Shpergl/Automotive/AC_controller/hw/Project Outputs for AC_controller/BOM/Bill of Materials.PDF

Component | list | | Bill of Materials for Project [AC_controller.PrjPcb] (No PCB Document Selected)
Source Data From: AC_controller.PrjPcb | | Contact: | | Generated by:
Project: AC_controller.PrjPcb | <Parameter ClientCompanyName not found>
Variant: | None | <Parameter ClientContactName not found> | FEDEVEL <Parameter ClientContactEmail not found>
Report Date: | 1/3/2025 | 2:23 PM | <Parameter ClientWebsite not found> | http://www.fedevel.com

### Print Date: 03-Jan-25 2:23:46 PM

# | #Column Name Error:' Category | Manufacturer 1 | Manufacturer Part Number 1 | Footprint | Description | Quantity | Supplier 1 | Supplier Part Number 1 | Supplier Order Qty 1 | Supplier Stock 1 | Supplier Unit Price 1 | Supplier Subtotal 1 | Supplier Currency 1

1 | | | | CAPAE430X550N | ELCO 20% | 3 | Farnell | 647-UWF1C100MCL1GB
2 | | | | CAPC2012X88N | X7R 10% 0805 | 8 | Farnell | 80-C0805C104K9R
3 | | | | CAPC2012X88N | | 4 | Farnell
4 | | Panasonic | EEE-FC1E101AP | CAPAE9983X102N | PANASONIC - EEEFC1E101AP - CAP, ALU | 2 | Farnell | 2254349 | | 500 | | | EUR
5 | | Murata | GRM21BR71C475KA73L | CAPC2012X140N | X7R 10% 0805 | 4 | Farnell | 1797015 | 12 | 0 | 0.45 | 5.44 | GBP
6 | | | | CN_10pin_MFGK-10 | Molex, Micro-Fit 3.0, 43045, 10 Way, 2 | 1 | kosmodrom.ua | 00-00041120
7 | | | | CN_20pin_MFGK-20 | Molex, Micro-Fit 3.0, 43045, 20 Way, 2 | 1 | kosmodrom.ua | 00-00041123
8 | | Vishay Lite-On | LTV-817S | IC_LiteOn_ LTV-817S | Transistor Output Optocouplers | 8 | Mouser | 859-LTV-817S | 24 | 14850 | 0.24 | 5.69 | USD
9 | | | | DO-214AC | Transient Voltage Suppressors | 2 | | SMAJ15A
10 | | | | MCH_BSC_SS_112L | Small relay 6 pins 12V, 2A | 5
11 | | | | | | 1
12 | | | | DO-214AC | M7 Diode, max 30A | 4
13 | | | | VSSOP-10 | Analog to Digital Converters - ADC 16B | 1
14 | | Raspberry Pi | SC0915 | MOD_Raspberry_Pi_Pico | Single Board Computers Raspberry Pi Pico | 1 | Mouser | 358-SC0915 | 3 | 8321 | 4.00 | 12.00 | USD
15 | | | | MOD_MCP2515 | CAN bus module | 1 | Arduino.ua
16 | | | | MOD_MP1584_3A | DC-DC converter 3A | 2 | Arduino.ua
17 | | Nexperia | BC847B215 | SOT23 | Bipolar Transistors - BJT NPN 45V 100mA | 5 | Mouser | 771-BC847B-T/R | 15 | 163004 | 0.07 | 0.99 | USD
18 | | | | TO-252 | 30V P-Channel MOSFET | 2
19 | | Nexperia | 2N7002BKW115 | SOT65P210X110-3N | NXP - 2N7002BKW - MOSFET, N CH, 60V, | 2 | Farnell | 1894713RL | | 16273 | | | EUR
20 | | | | RESC2012X60N | RESISTOR, 0805, 1K, 1%, SMD | 11 | Farnell | 9237496
21 | | | | RESC2012X60N | RESISTOR, 0805, 10K, 1%, SMD | 19 | Farnell
22 | | Yageo | RC0805FR-074K7L | RESC2012X60N | RESISTOR, 0805, 4K7, 1%, SMD | 1 | Farnell | 9237704 | | 650700 | | | EUR
23 | | | | RESC2012X60N | RESISTOR, 0805, 100K, 1%, SMD | 3 | Farnell
24 | | Vishay Dale | RCG08050000Z0EA | RESC2012X60N | Thick Film Resistors - SMD ZERO OHM | 2 | Mouser | 71-RCG08050000Z0EA | 6 | 14668 | 0.12 | 0.72 | USD
25 | | Yageo | RC0805FR-07100RL | RESC2012X60N | RESISTOR, 0805, 100R, 1%, SMD | 15 | Farnell | 9237364 | 45 | 997154 | 0.02 | 0.86 | EUR
| | | | | | 108 | | | 105 | 25.695
Approved | | | | Notes Price for 1pcs | | | | | | | | USD
3 pcs: | Total | USD

25.695

8.57
