Shpergl/Automotive/AC_fan/hw/AC_fan/Project Outputs for AC_fan/BOM/Bill of Materials-AC_fan.xlsx

Comment | Description | Designator | Footprint | LibRef | Quantity
CN_2pin_XT60PW-M | 30A, 2 pin | CN1, CN3 | CN_2pin_XT60-M | 02_10140 | 2
CN_1X2M |  | CN2 | CN_XH2.54-2P-MALE | 02_10135 | 1
DIO | Schottky Diodes & Rectifiers 3 Amp 30 Volt | D1 | DO-201AD-Horizontal | 03_00101 | 1
IC_LiteOn_LTV817 | Transistor Output Optocouplers Optocoupler Phototrans | D2 | IC_LiteOn_ LTV-817S | 07_00275 | 1
TRS_IRFP2907PbF | N-channel Power MOSFET Si 75V 209A 3-Pin(3+Tab) | Q1 | TO-247AC | 19_00049 | 1
RES | RESISTOR, 0805, 330R, 1%, SMD, RESISTOR, 0805, 10K, 1%, SMD | R2, R3, R4 | RESC2012X60N | 15_00323, 15_00341 | 3
