Shpergl/Automotive/AC_fan/hw/AC_fan/Project Outputs for AC_fan/ExportSTEP/AC_fan.step

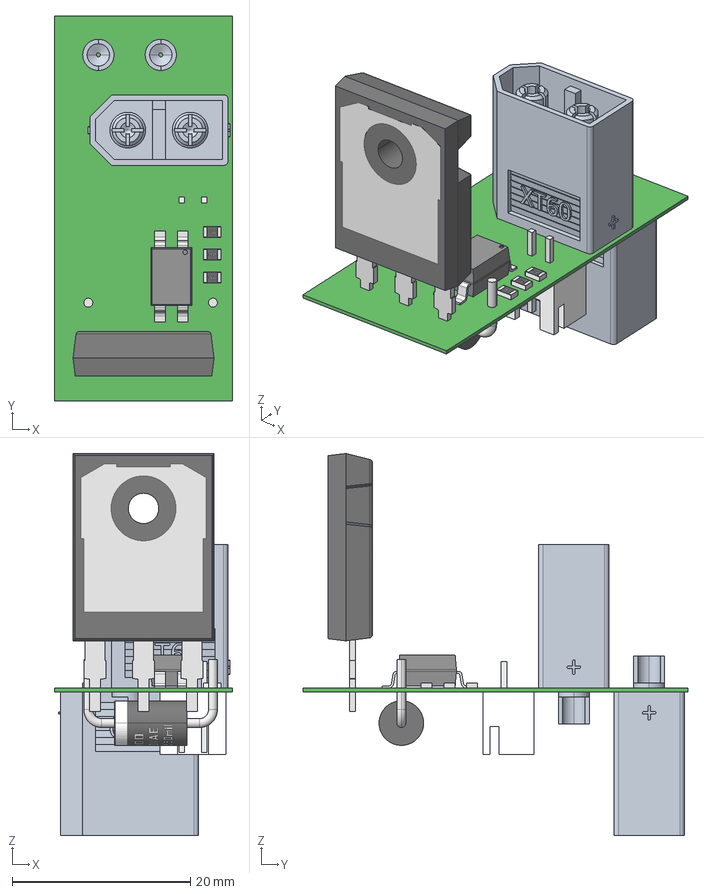
[picture p1: CAD file, 2025-03-06]
AC_fan/hw/AC_fan/Project Outputs for AC_fan/ExportSTEP/AC_fan.step
20.0 x 43.1 x 42.8 mm
TO-247AC_Normal_Size_rev1.1
XT60_Macho x 2
DO-201AE_Normal_550mil_rev1.0
RES_0805 x 3
SW3dPS-4-SMD
JST B2B-XH-A
