Shpergl/Automotive/(list of files, cad)

Other CAD files:
AC_fan/hw/AC_fan/Project Outputs for AC_fan/ExportSTEP/AC_fan_v_1_0.step
