Shpergl/Automotive/AC_controller/hw/Project Outputs for AC_controller/Schematic Print/Schematic Prints.PDF

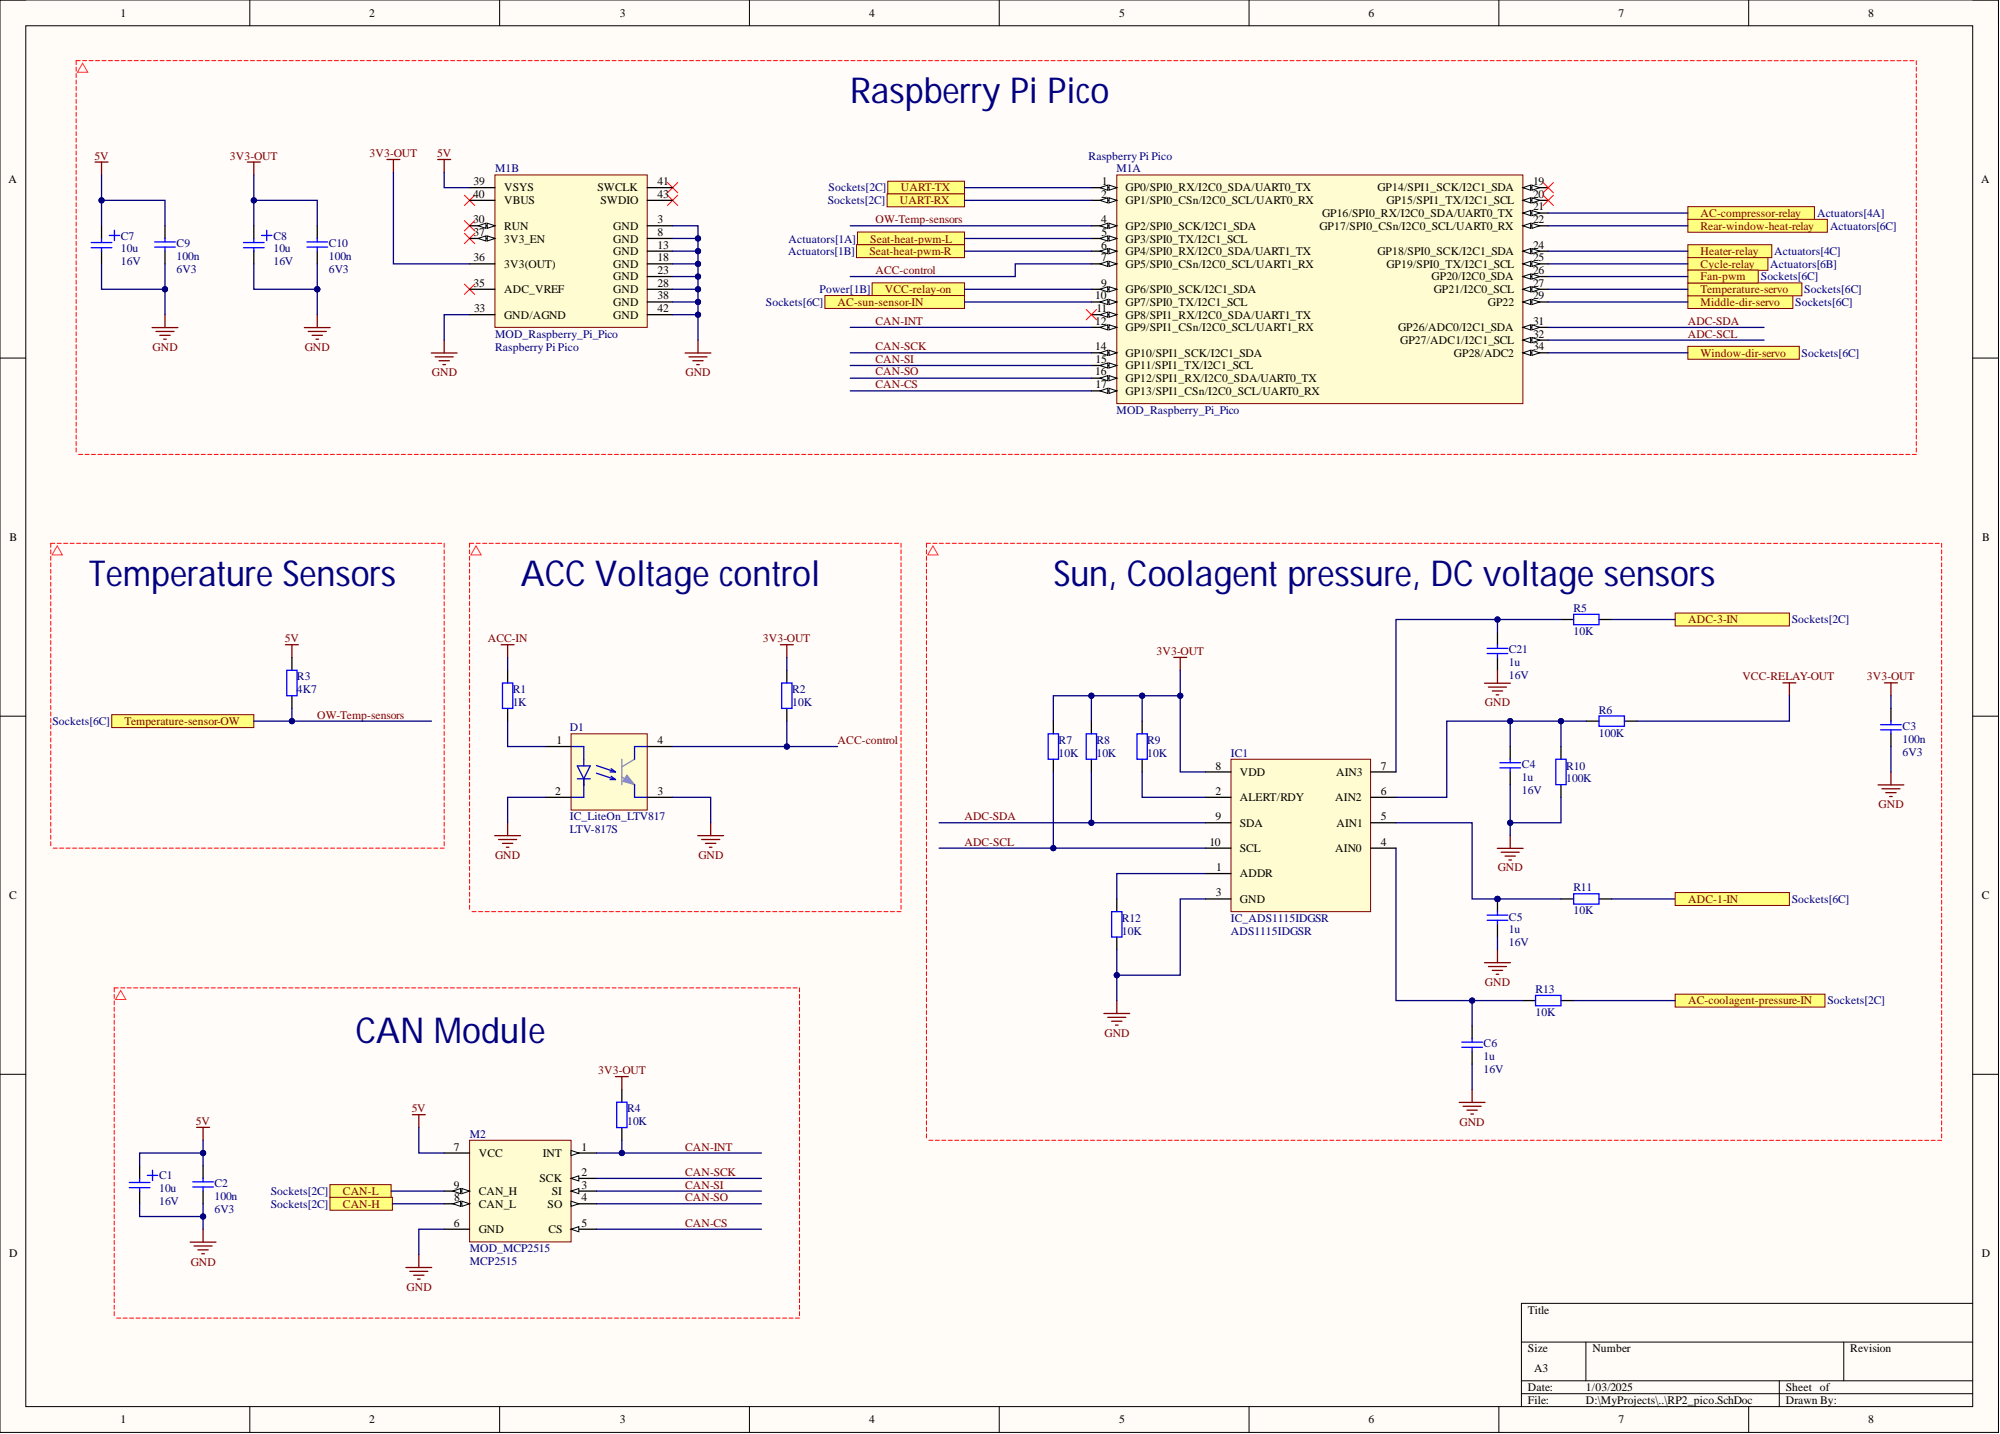
[picture p2: page 1]

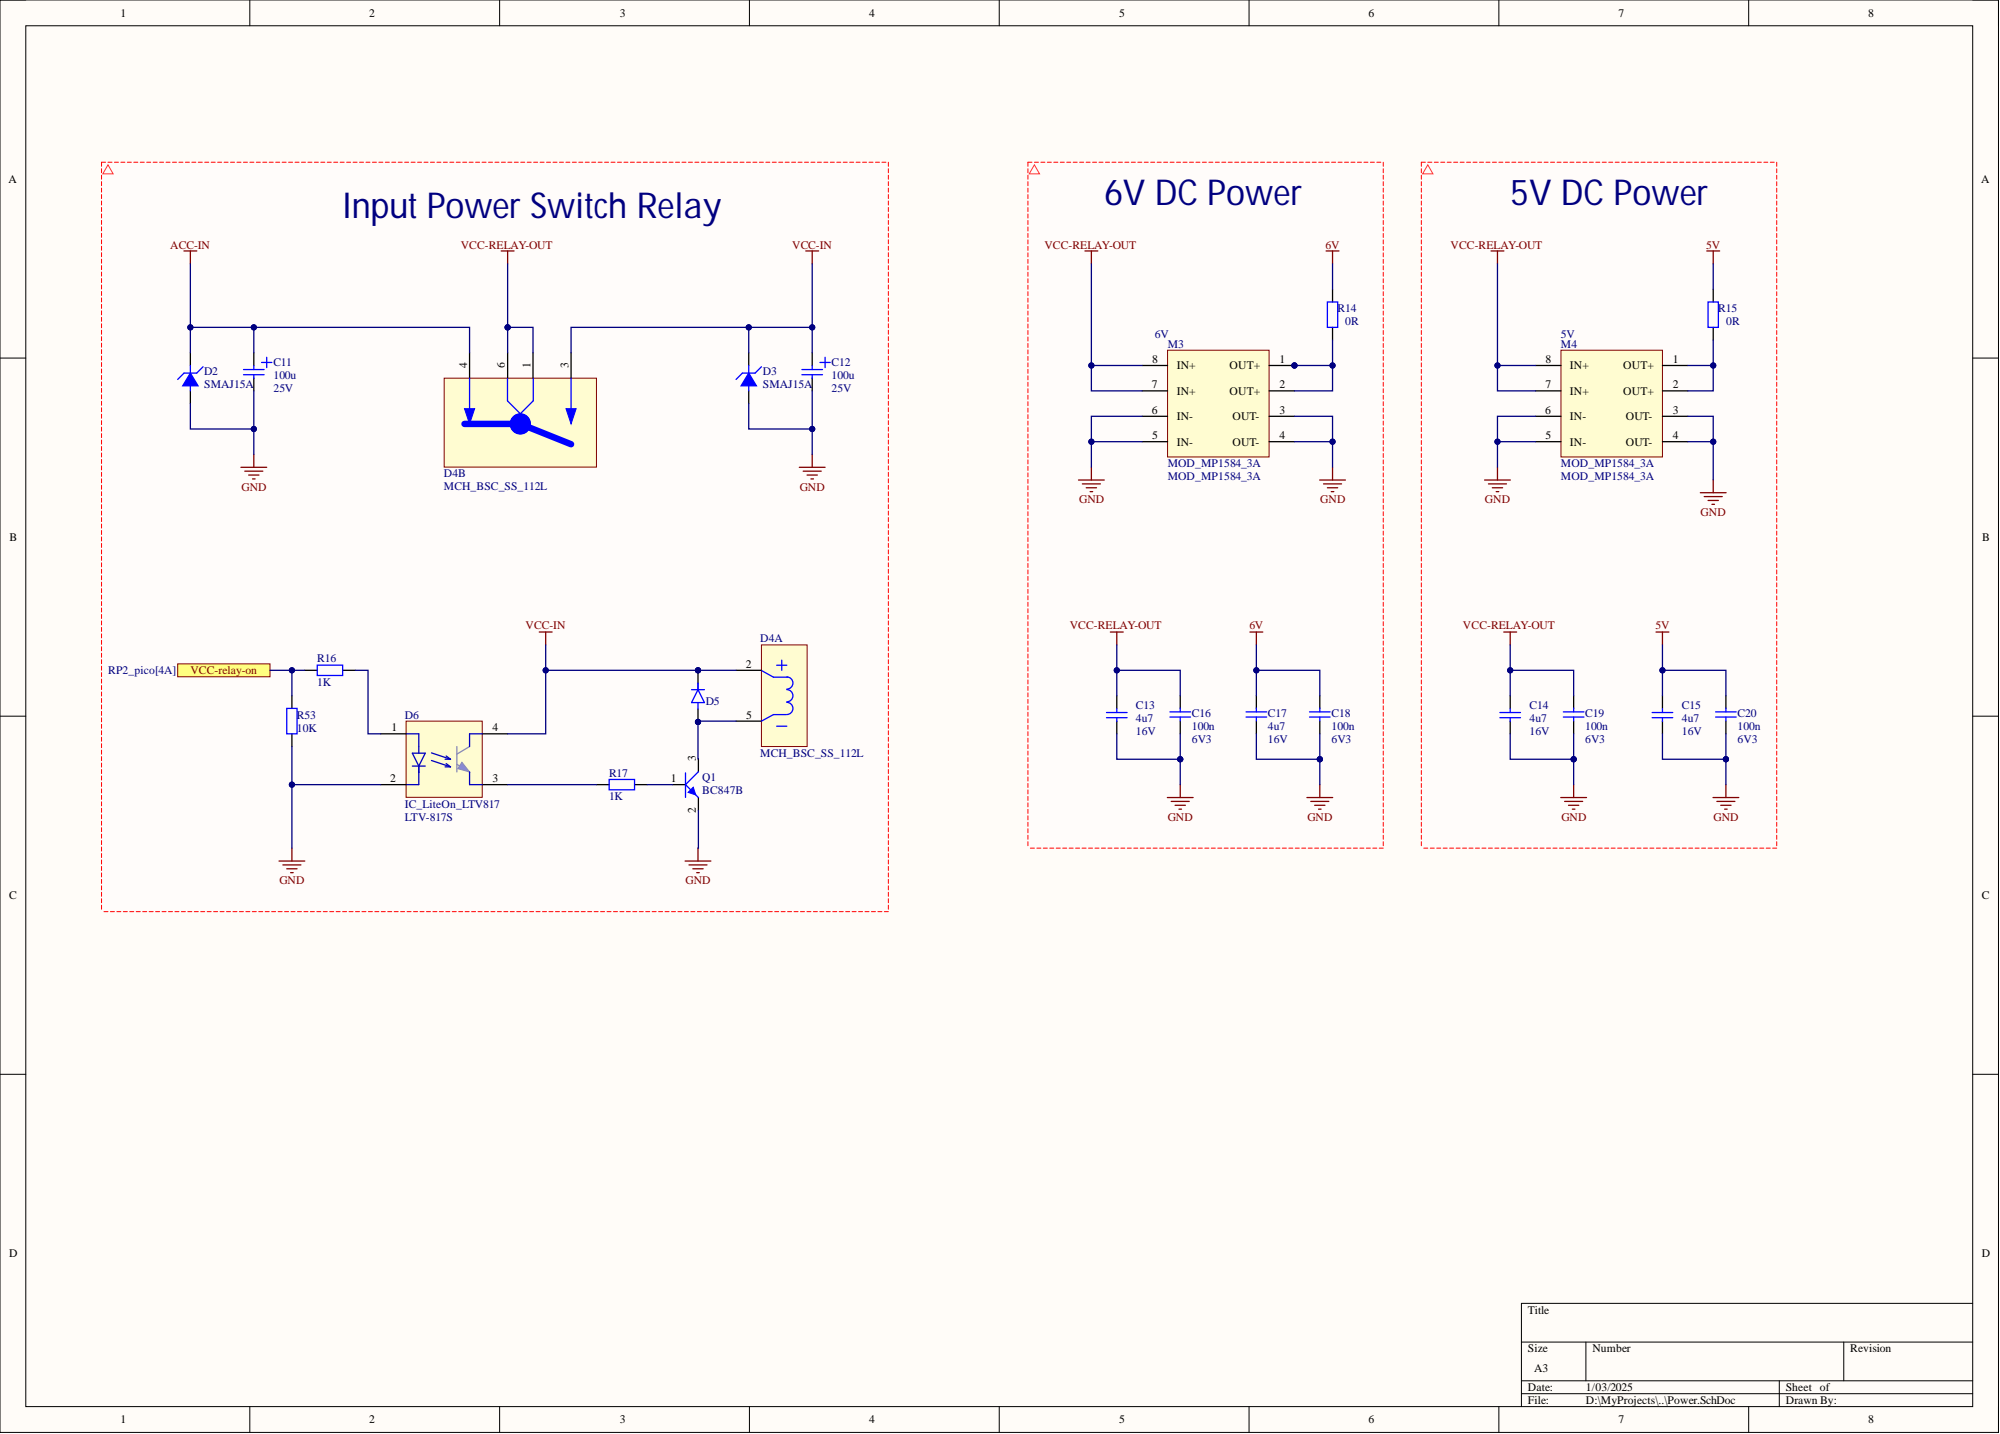
[picture p3: page 2]

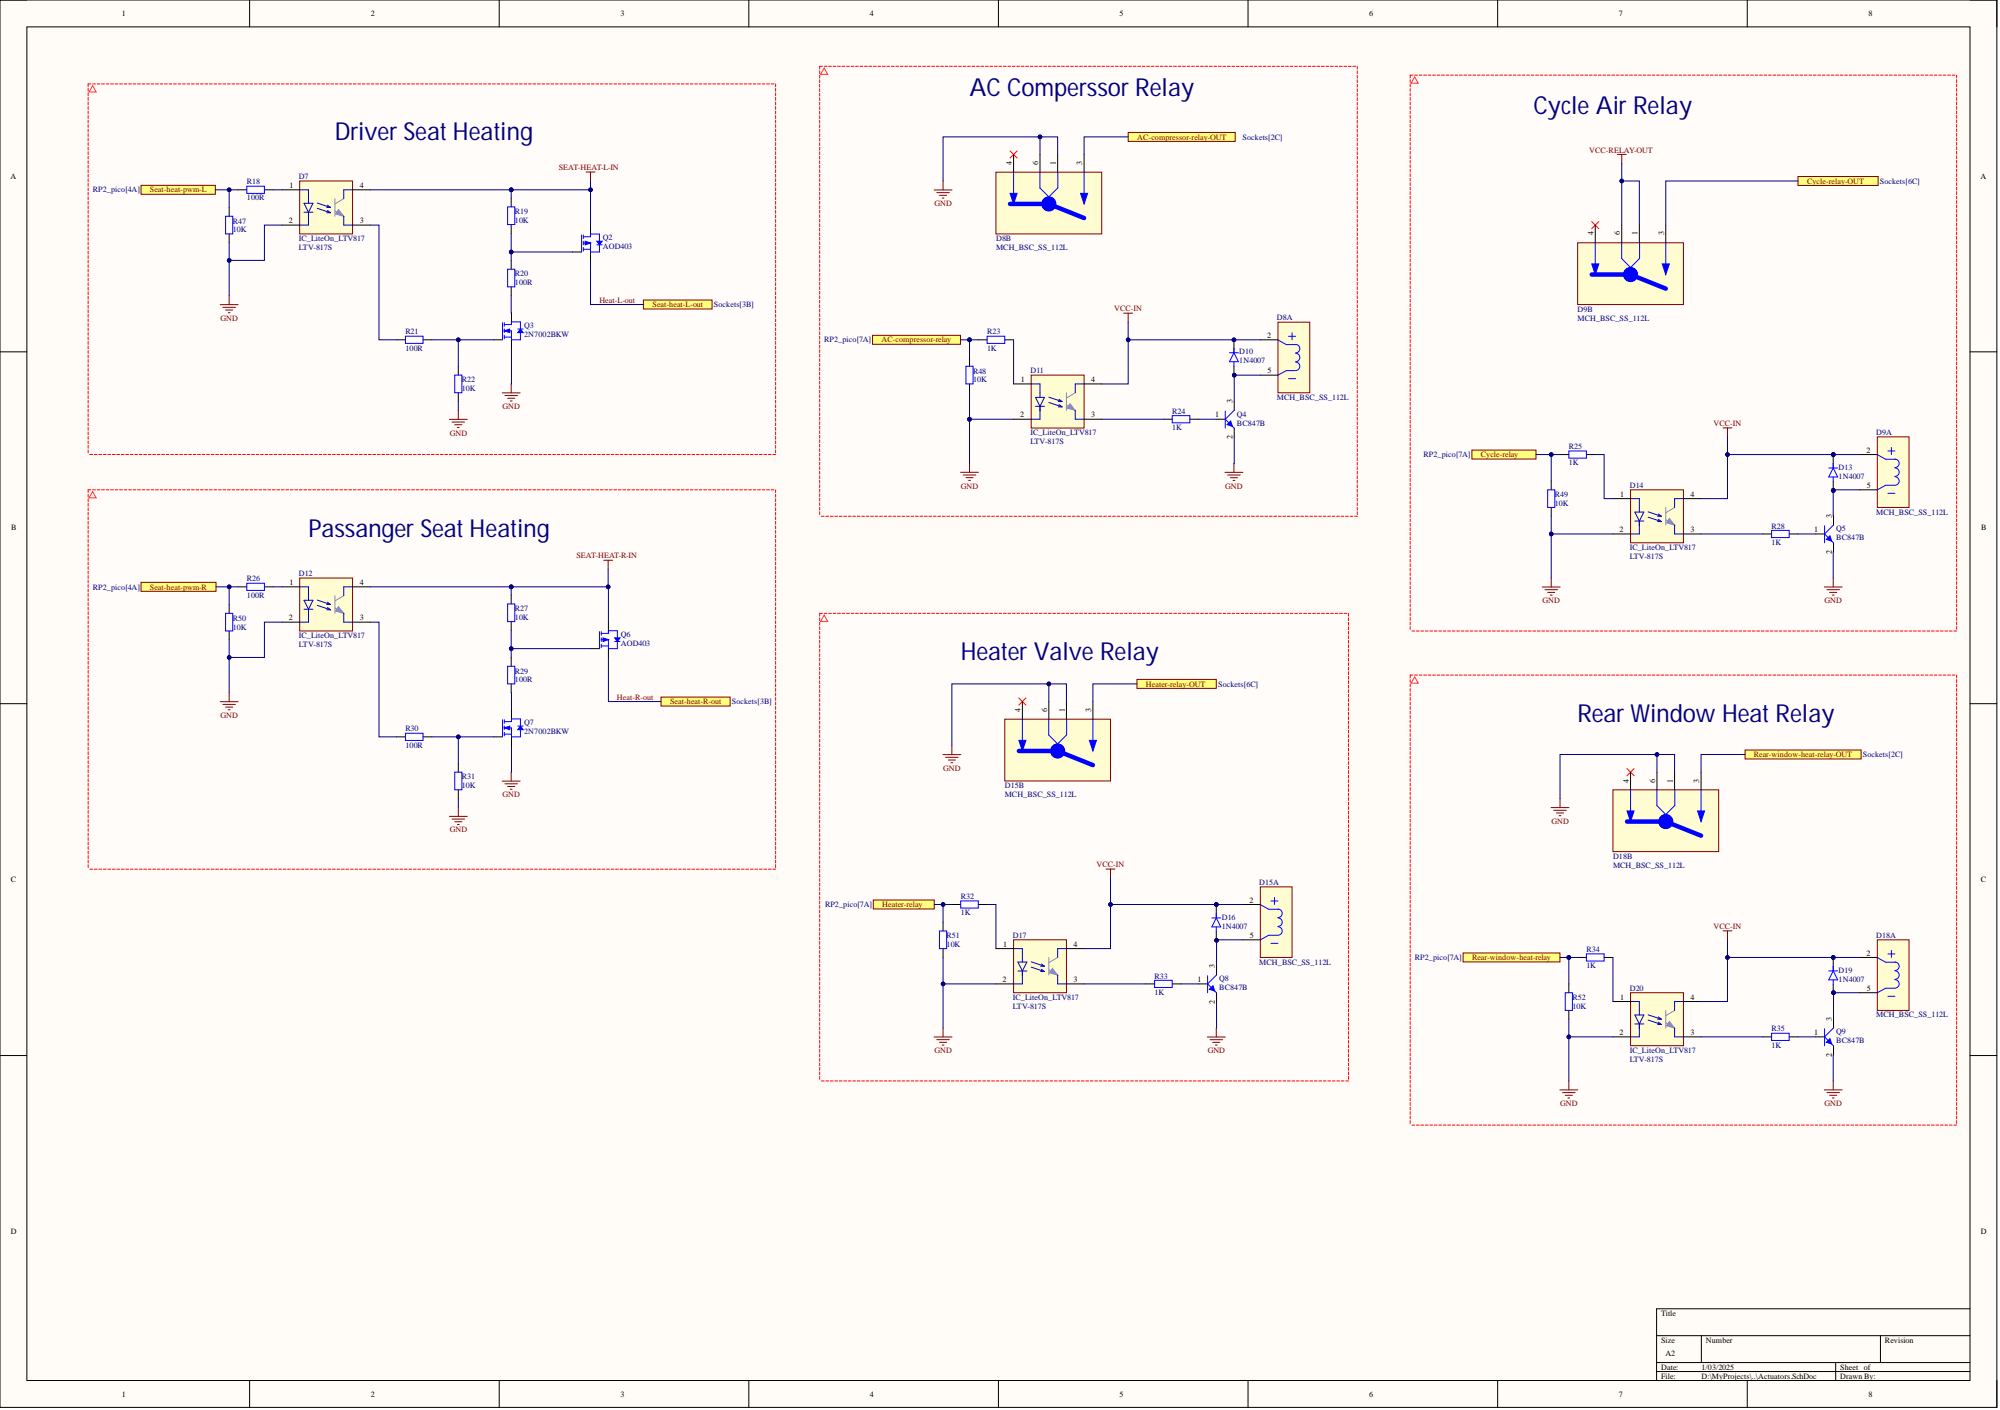
[picture p4: page 3]

Rear Window Heat Relay

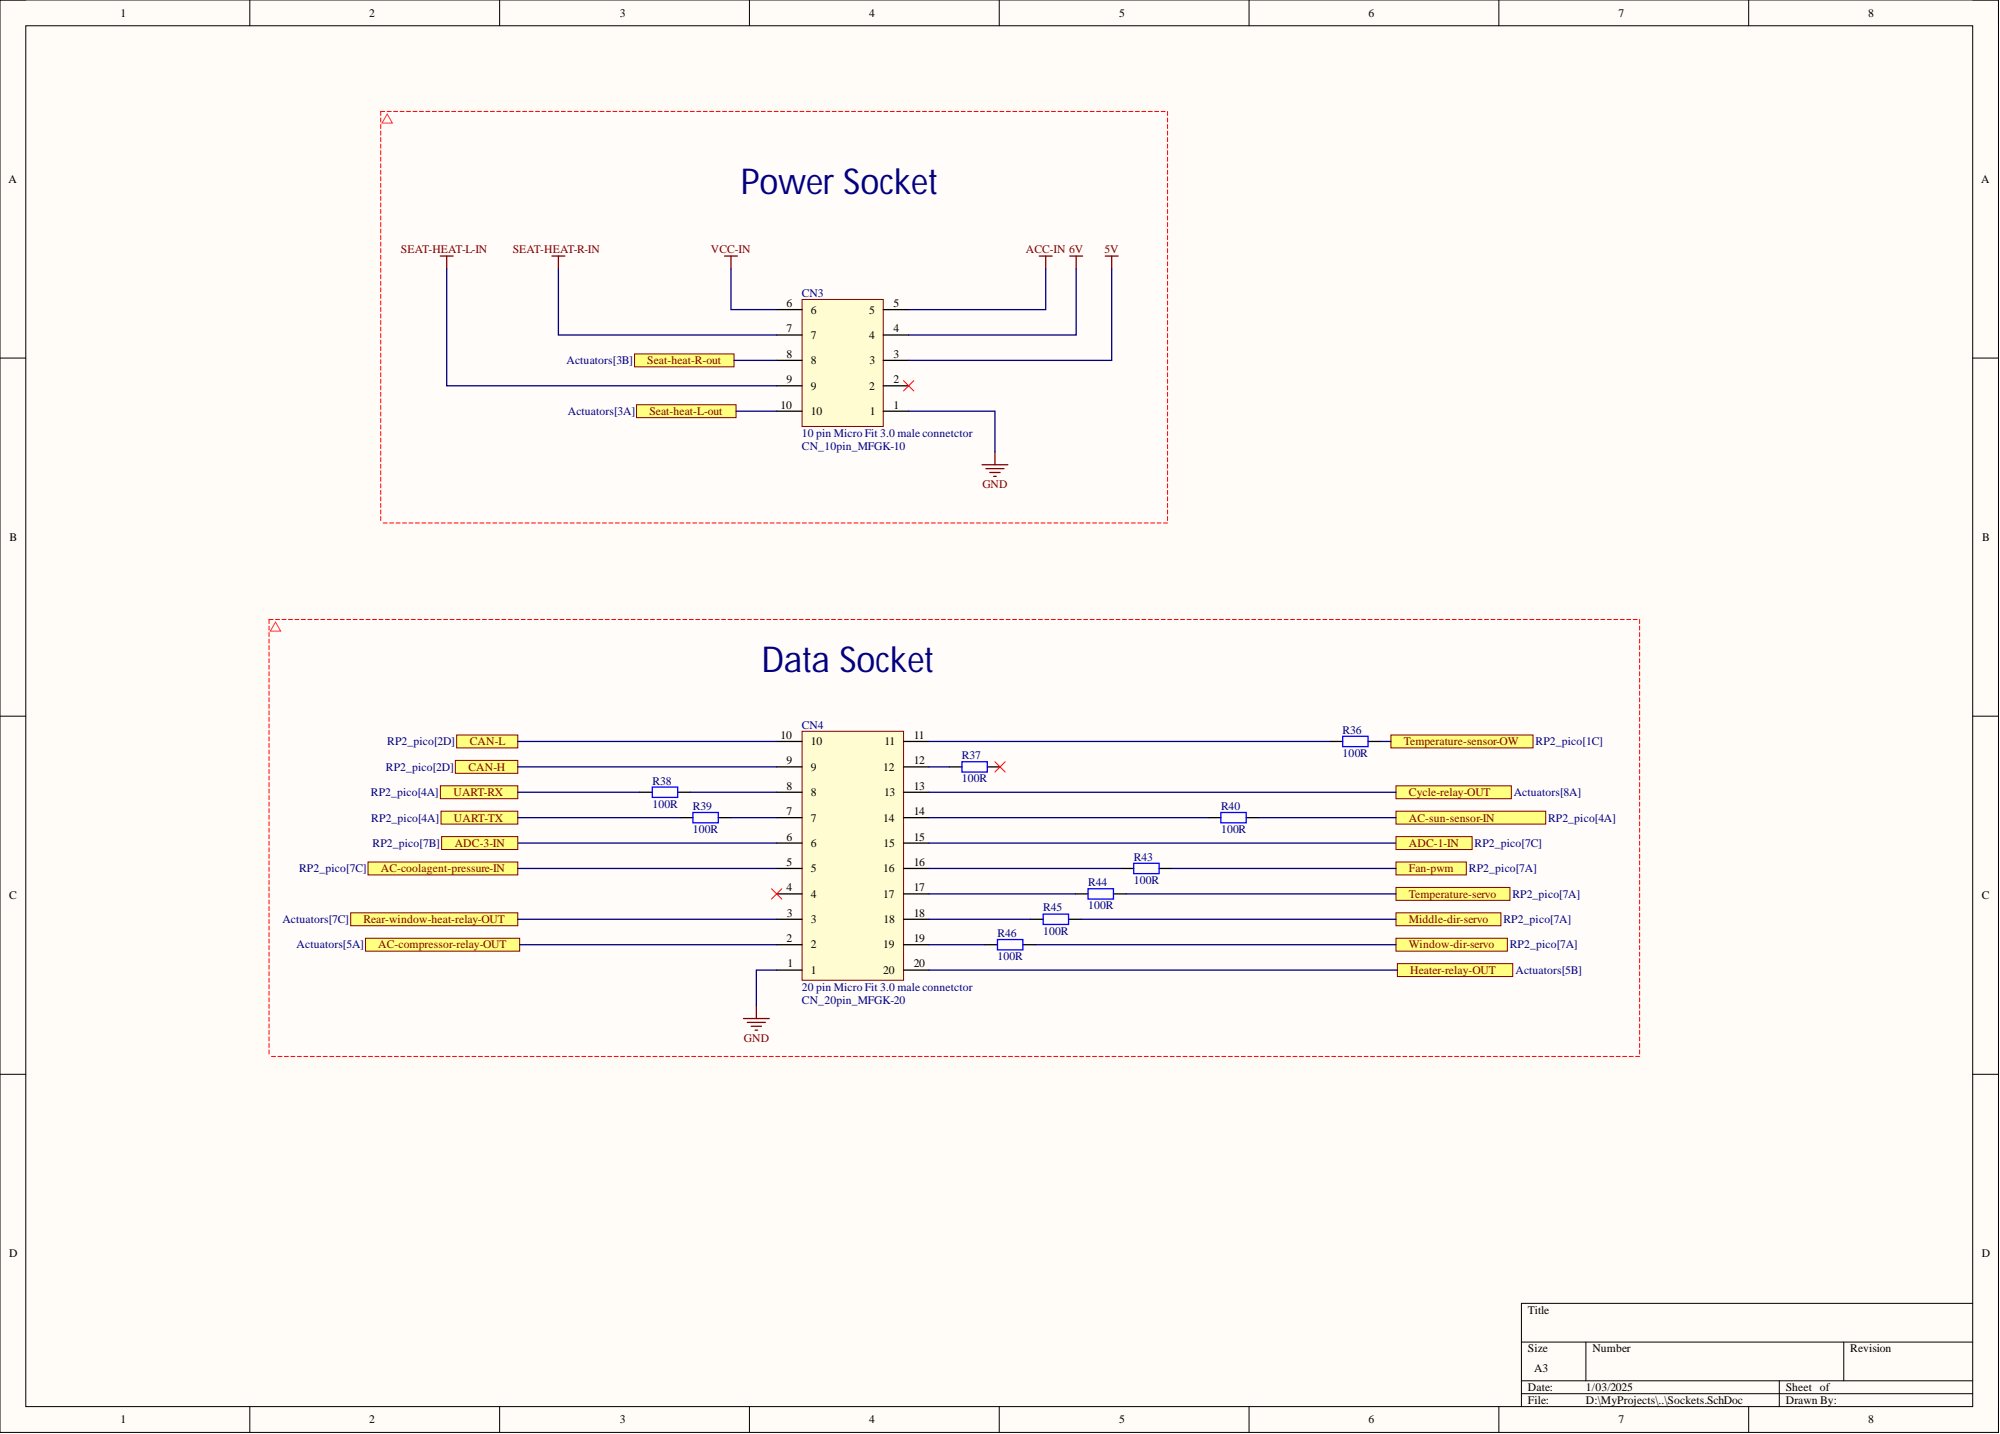
[picture p5: page 4]

10 pin Micro Fit 3.0 male connetctor
CN_10pin_MFGK-10

20 pin Micro Fit 3.0 male connetctor
CN_20pin_MFGK-20
