Shpergl/Automotive/AC_controller/hw/Project Outputs for AC_controller/PCB Print/Layers.PDF

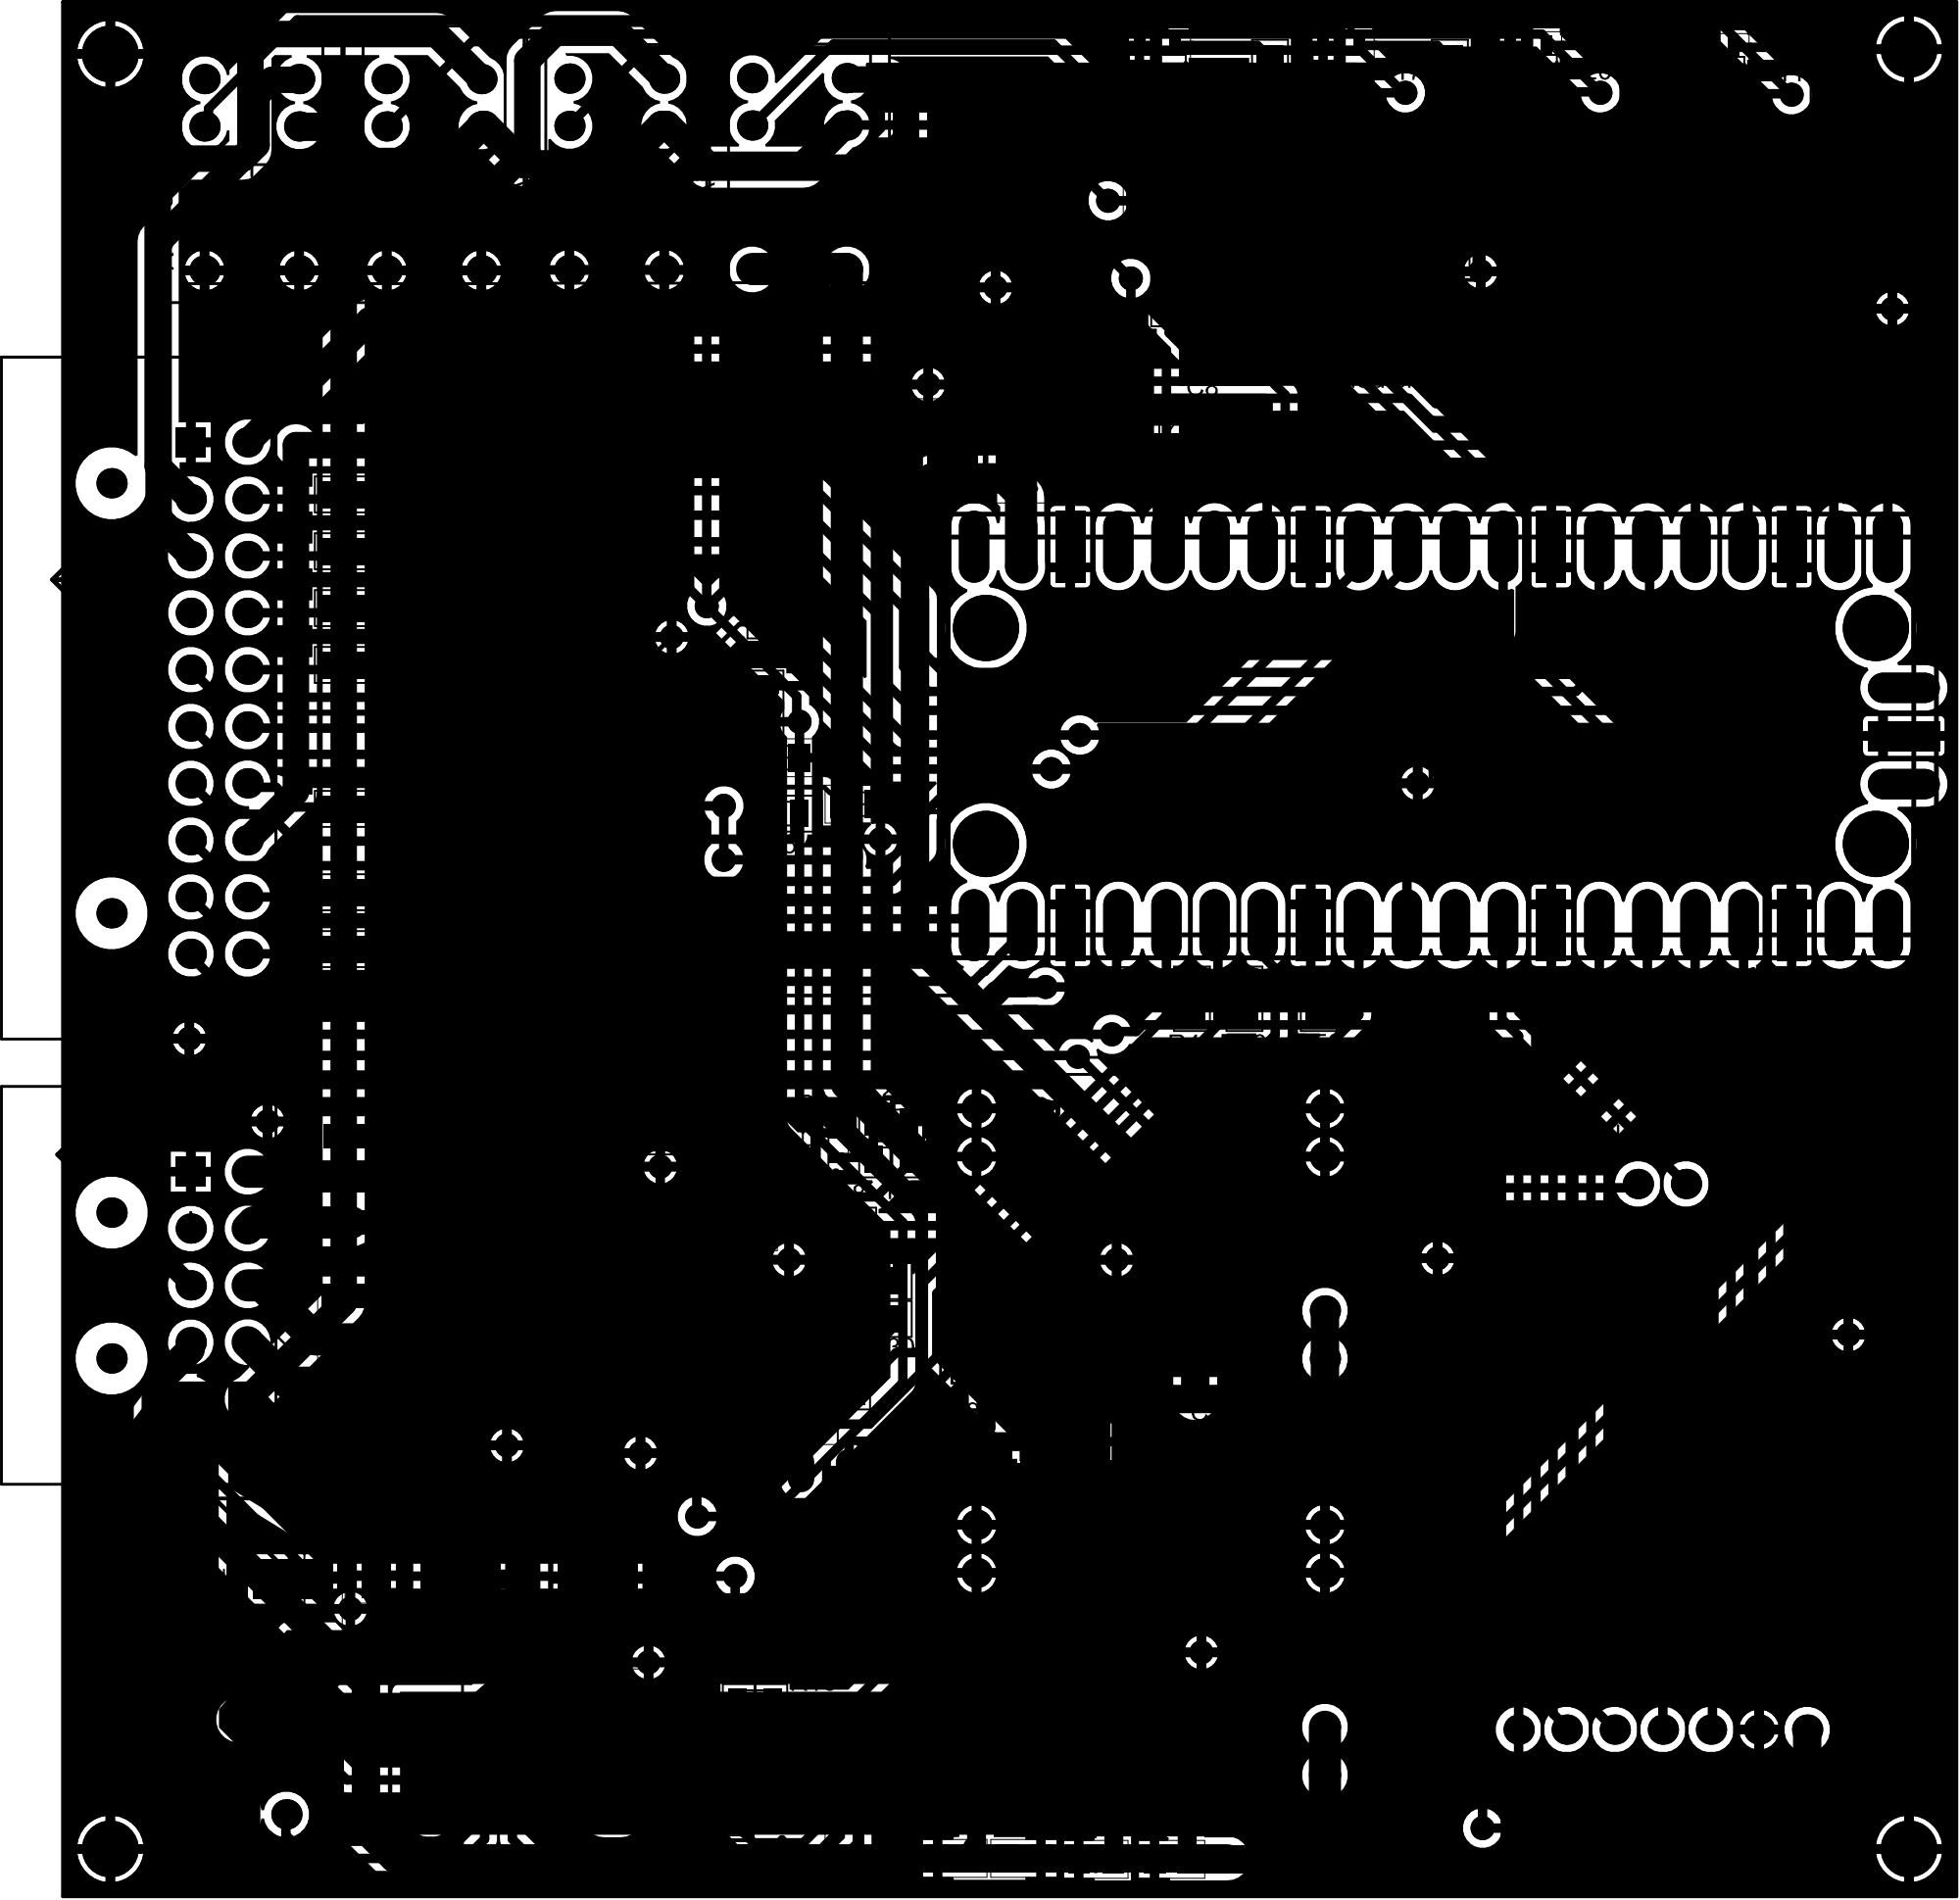
[picture p6: page 1]
