Shpergl/Automotive/AC_fan/hw/AC_fan/Project Outputs for AC_fan/AC_fan_V_1_0_schematic.PDF

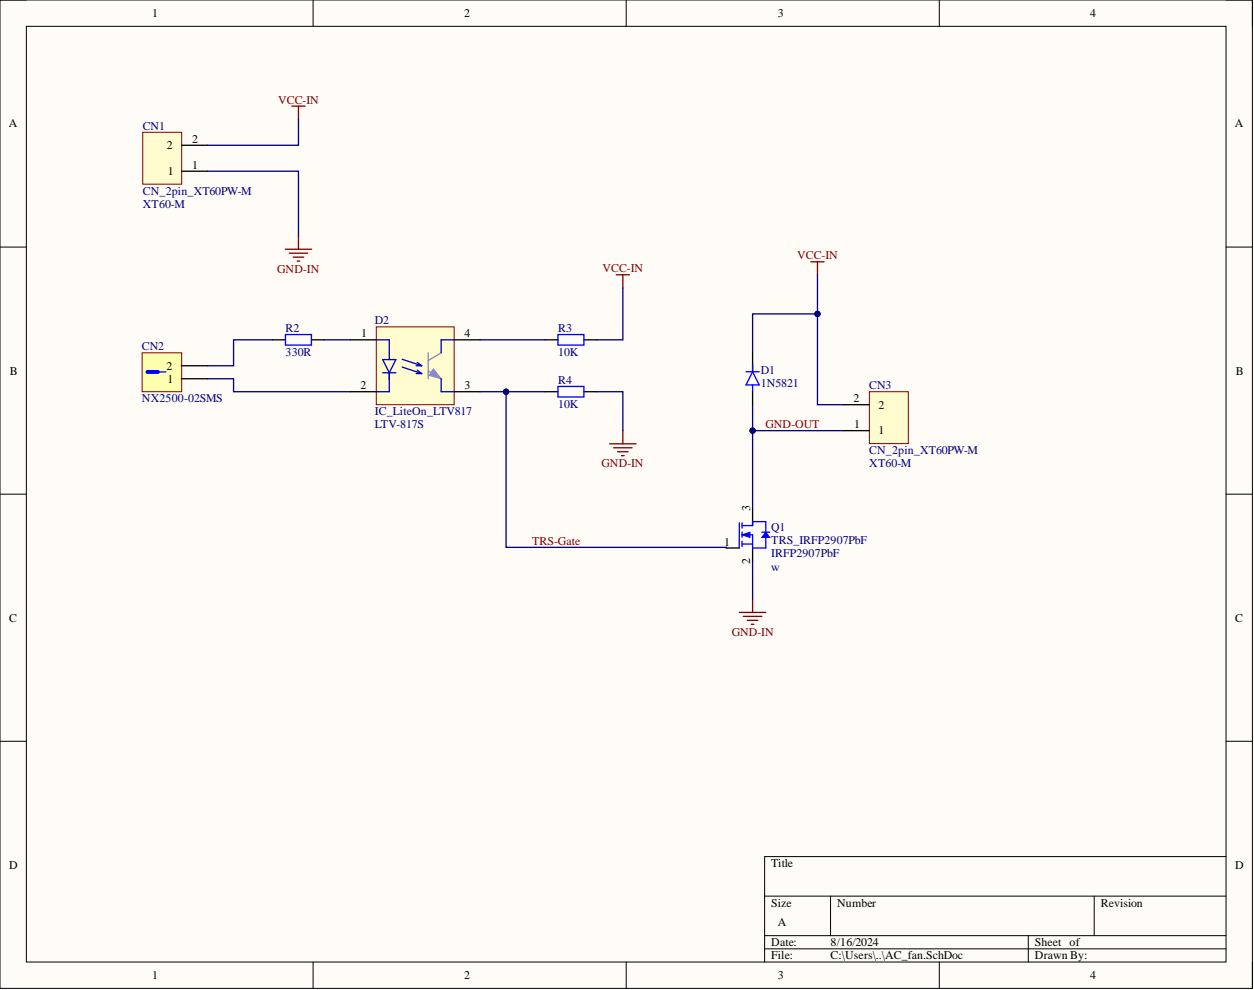
[picture p7: page 1]
