Shpergl/Automotive/(list of files, drawings)

Other design files:
AC_controller/hw/AC_controller.PrjPcb
AC_controller/hw/Actuators.SchDoc
AC_controller/hw/Power.SchDoc
AC_controller/hw/RP2_pico.SchDoc
AC_controller/hw/Sockets.SchDoc
AC_fan/hw/AC_fan/AC_fan.PcbDoc
AC_fan/hw/AC_fan/AC_fan.PrjPcb
AC_fan/hw/AC_fan/AC_fan.SchDoc
