Shpergl/Automotive/AC_controller/sw/devices/sid_text.py

import time
from machine import Timer

from can.can_bus import get_CAN_bus
from constants import UART_TYPES, AC_COOL_MODE
from controllers.climate_controller import get_climate_controller
from helpers.observer import Observer
from helpers.utils import chunk_string, ascii_to_hex

TEXT_FOR_EVENT = {
    AC_COOL_MODE.ON: "AC is ON",
    AC_COOL_MODE.OFF: "AC is OFF",

}


class SIDTextDevice(Observer):
    RAW_MAX_LEN = 12
    MESSAGES_ORDER = (0x45, 0x04, 0x03, 0x02, 0x01, 0x00)
    TEXT_CONTROL_ID = 0x34c
    TEXT_SHOW_ID = 0x32c
    PACKET_SEND_INTERVAL = 0.01

    def __init__(self):
        # self.subscribe(get_climate_controller())
        self._can = get_CAN_bus()
        self._timer = Timer()
        self._messages = []

    def _text_control(self):
        data = [0x00] * 8
        data[0] = 0x18  # 0x018 ACC
        data[1] = 0x00  # 0x00 -1,2 rows,0x01 - 2 row, 0x02 - ?
        data[2] = 0x00  # Priority - 0x00 -higher 0xff - lower
        data[3] = 0x23  # Priority - 0x00 -higher 0xff - lower
        self._can.send(self.TEXT_CONTROL_ID, data)

    def _show_text(self, text):
        raw_string = chunk_string(text, self.RAW_MAX_LEN)
        print(raw_string)

        for msg_idx, msg_ord in enumerate(self.MESSAGES_ORDER):
            data = [0x00, 0x96, 0x00, 0x20, 0x20, 0x20, 0x20, 0x20]
            data[0] = msg_ord
            if msg_idx < 3:
                data[2] = 0x81
                chunk_str = chunk_string(raw_string[0], 5)
                chunk_idx = msg_idx
            else:
                data[2] = 0x82
                chunk_str = chunk_string(raw_string[1], 5) if len(raw_string) > 2 else []
                chunk_idx = msg_idx - 3

            if chunk_idx < len(chunk_str):
                for i, c in enumerate(chunk_str[chunk_idx]):
                    data[3 + i] = ascii_to_hex(c)

            self._can.send(self.TEXT_SHOW_ID, data)
            msg_idx += 1
            time.sleep(self.PACKET_SEND_INTERVAL)

    def show_text(self, text):
        self._text_control()
        self._show_text(text)

    def update(self, subject_type, subject):
        pass


sid_text_device = None


def get_sid_text_device():
    global sid_text_device
    if sid_text_device is None:
        sid_text_device = SIDTextDevice()
    return sid_text_device
