Shpergl/Automotive/(commit log)

2024-08-14 direcory rename. AC controller HW was added.
    [AC_controller.PrjPcb, Actuators.SchDoc, Power.SchDoc, RP2_pico.SchDoc, Sockets.SchDoc]
2024-08-16 AC fan project was added.
    [AC_fan.PcbDoc, AC_fan.PrjPcb, AC_fan.SchDoc]
2024-08-16 AC controller corrections.
    [AC_controller.PrjPcb, Actuators.SchDoc, Power.SchDoc, RP2_pico.SchDoc]
2024-08-19 Gerber manufacturing files were added.
    [AC_controller.PrjPcb, AC_fan.PcbDoc, AC_fan.PrjPcb, AC_fan_v_1_0.step]
2024-10-22 repo migration
    [AC_controller.PrjPcb, AC_fan.PcbDoc, AC_fan.SchDoc, Actuators.SchDoc, Power.SchDoc, RP2_pico.SchDoc, Sockets.SchDoc]
2024-11-06 AC controller v1.1 was added
    [AC_controller.PrjPcb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]
2025-01-03 Schematic fixes and code structure adjustments
    [AC_controller_v1_1_Board.gbr, AC_controller_v1_1_Copper_Signal_Bot.gbr, AC_controller_v1_1_Copper_Signal_Top.gbr, AC_controller_v1_1_Drawing_1.gbr, AC_controller_v1_1_Drillmap_1.gbr, AC_controller_v1_1_Legend_Bot.gbr, AC_controller_v1_1_Legend_Top.gbr, AC_controller_v1_1_NPTH_Drill.gbr]
2025-03-06 parking module removed
    [AC_fan.PcbDoc, AC_fan.PrjPcb, AC_fan.step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]
